spyadrian/fpga-biometric-lock/docs/specification-fr.pdf

## Verrou biométrique

### Cahier des charges du projet FPGA présenté par

## Valentin Bernillon & Adrian Spycher

### Informatique et systèmes de communication avec orientation en systèmes embarqué

### April, 2025

Professeur-e HES responsable Laurent Gantel, Gabriel Da Silva Marques

Valentin Bernillon & Adrian Spycher – Verrou biométrique – April, 2025

## Table des matières

II

## Chapitre 1. Verrou biométrique sur FPGA avec Microblaze et

## Interfaces AXI4-Lite

### 1.1 Objectif

Concevoir et implémenter un système de déverrouillage biométrique utilisant un FPGA sur

la carte Nexys Video. Ce système utilise un processeur soft-core Microblaze pour la gestion

générale et des interfaces AXI4-Lite pour la communication avec les périphériques. Ce projet

utilise une caméra ainsi que l’algorithme LBPH pour la reconnaissance faciale.

### 1.2 Composants du Système

a ) Capteur de Proximité

Un capteur de proximité est utilisé pour détecter l’approche d’un utilisateur. Ce capteur génère

une interruption sur le FPGA lorsqu’une proximité est détectée.

b ) Caméra et Reconnaissance Faciale

Une caméra est intégrée au système pour capturer des images faciales. L’algorithme de recon-

naissance faciale LBPH est implémenté en VHDL pour analyser les images et identifier les

visages autorisés.

c ) Interfaces de Sortie

Un verrou utilisant un électro-aimant est activé pour déverrouiller physiquement une serrure.

d ) Interface Personnalisée

Une interface personnalisée en VHDL est conçue pour faciliter la communication entre le FPGA

et les périphériques spécifiques au projet, tels que le capteur de proximité et la caméra.

e ) Interface Fonctionnant par Interruption

Une interface est configurée pour fonctionner par interruption, permettant au système de réagir

en temps réel aux événements détectés par le capteur de proximité.

### 1.3 Fonctionnement

Lorsqu’un utilisateur s’approche du capteur de proximité, celui-ci déclenche une interruption

sur le FPGA. La caméra capture alors une image faciale, que l’algorithme LBPH analyse pour

reconnaître l’utilisateur. Si l’utilisateur est autorisé, la LED de déverrouillage s’allume en vert

et/ou le moteur de déverrouillage est activé, permettant ainsi l’accès au système sécurisé.

### 1.4 Schéma global

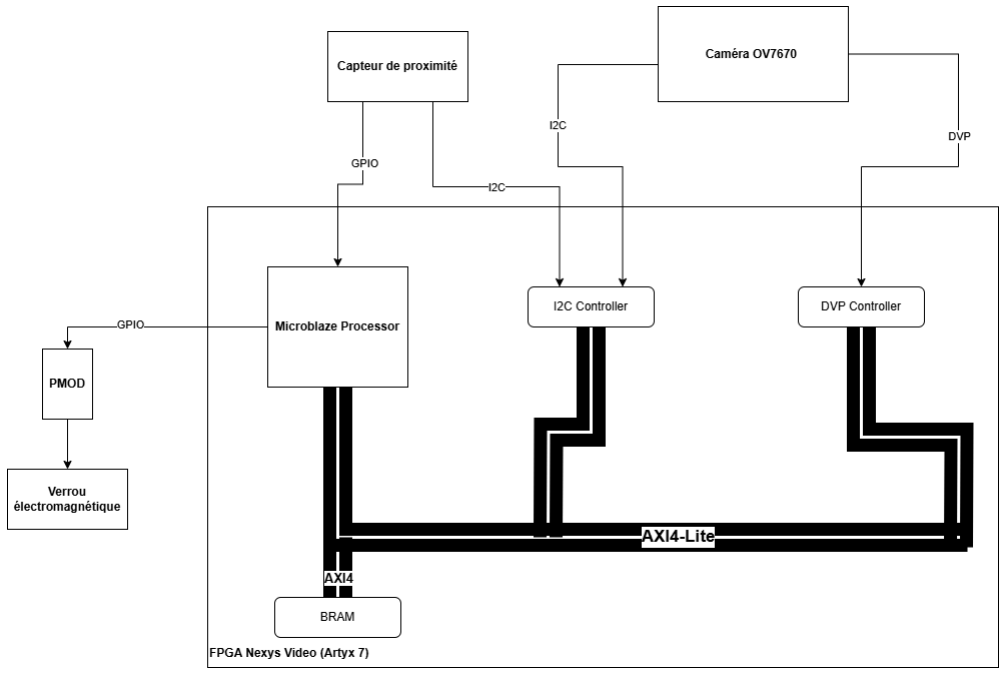
[picture p2: figure]

Fig. 1. – Schéma global du projet de verrou biométrique

### 1.5 Matériel Utilisé :

a ) FPGA - Nexys Video

La Nexys Video, basée sur un FPGA Xilinx Artix-7, est un choix pertinent pour ce projet,

notamment parce que nous l’avons déjà utilisée en cours, ce qui facilite son intégration et son

exploitation.

b ) Caméra - OV7670

La caméra OV7670 est un capteur d’image CMOS à faible coût. Elle fonctionne avec une réso-

lution VGA (640x480) et un débit d’image de 30 FPS, elle est idéale pour les projets embarqués

nécessitant une acquisition rapide d’images en temps réel. Elle communique via une interface

parallèle 8 bits et utilise I2C pour la configuration, ce qui la rend facilement interfaçable avec

un FPGA comme la Nexys Video via un module AXI4-Stream.

- Datasheet (https://www.voti.nl/docs/OV7670.pdf)
- Tutoriel FPGA (https://www.fpga4student.com/2018/08/basys-3-fpga-ov7670-camera.html)

c ) Capteur de proximité

Le VCNL4040 est un capteur de proximité à interface I²C, parfaitement adapté pour détecter la

présence d’un utilisateur et générer une interruption vers le MicroBlaze. Intégré à notre projet,

il permettra de réveiller le système de reconnaissance faciale dès qu’une personne s’approche.

- Datasheet (https://www.vishay.com/docs/84274/vcnl4040.pdf)
- Mouser (https://www.mouser.ch/ProductDetail/Adafruit/4161?qs=d0WKAl%252BL4KYSXIse1Xv7Uw%3D%3D)
- Adafruit guide (https://www.adafruit.com/product/4161)

d ) Verrou à solénoïde - ROB-15324

Un solénoïde électromagnétique est un actionneur qui fonctionne en utilisant un champ magné-

tique pour attirer ou repousser un piston métallique. Alimenté en 5V ou 12V, il est contrôlé par

le FPGA Nexys Video via MicroBlaze.

- Référence (https://www.sparkfun.com/solenoid-12v-latch-lock.html)
- Mouser No : 474-ROB-15324
- Pmod HB3 (https://digilent.com/reference/pmod/pmodhb3/start)

e ) Langages et Outils

VHDL pour la programmation des interfaces et des algorithmes, Xilinx Vivado pour la concep-

tion et la synthèse du FPGA.
