spyadrian/fpga-biometric-lock/docs/presentation-fr.pdf

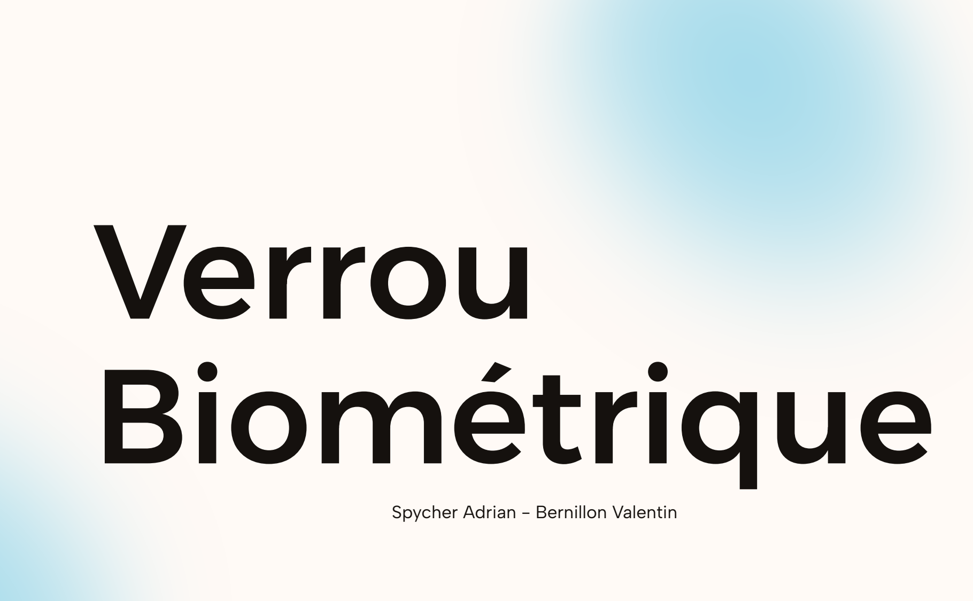
[picture p3: page 1]

# Verrou Biométrique

Spycher Adrian - Bernillon Valentin

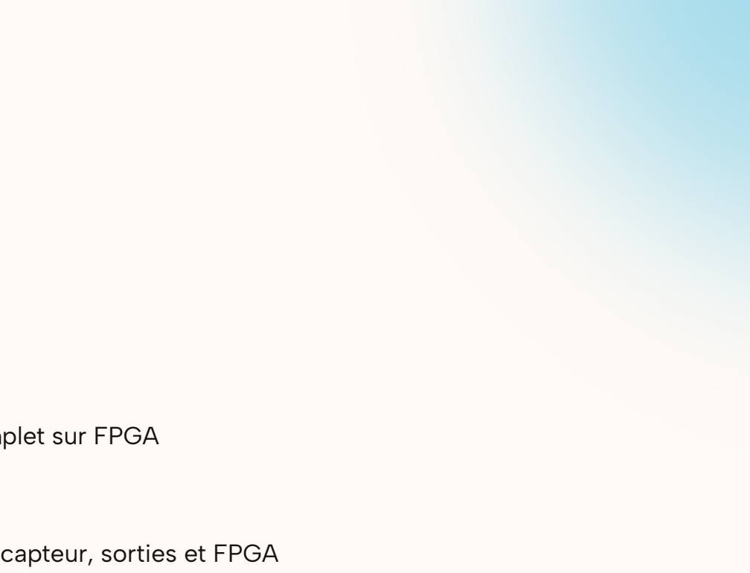
[picture p4: figure]

- Conception et implémentation d’un projet complet sur FPGA
- Mise en place d’un cahier des charges
- Proposition d’une solution complète, integrant capteur, sorties et FPGA

# Contexte

# Objectif

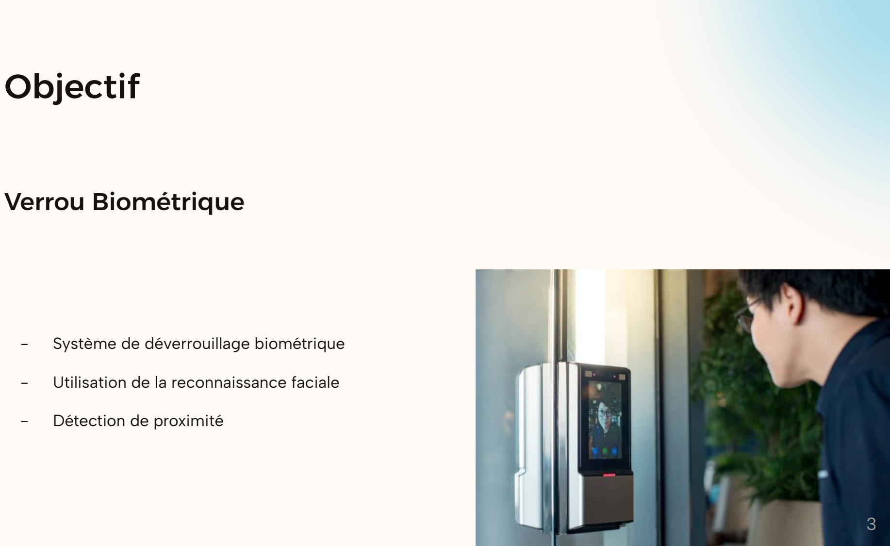
[picture p5: page 3]

- Système de déverrouillage biométrique
- Utilisation de la reconnaissance faciale
- Détection de proximité

## Verrou Biométrique

- Déverrouillage biométrique
- FPGA sur Nexys Video

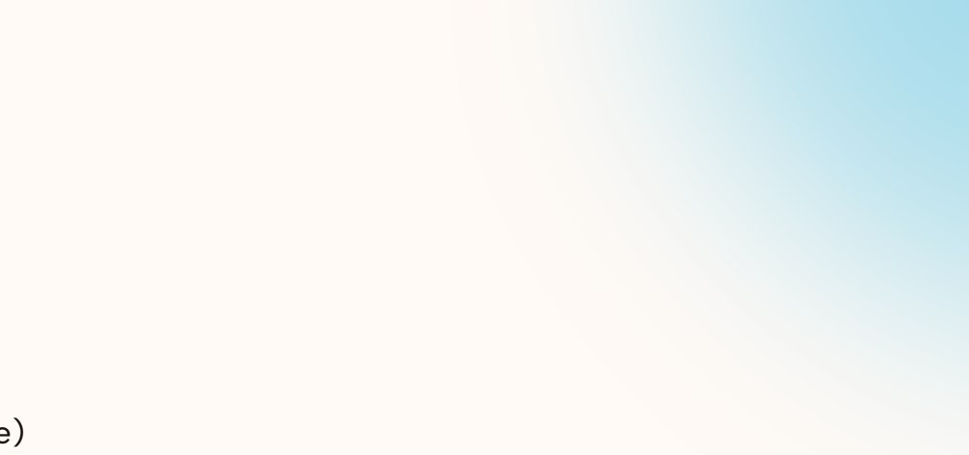
[picture p6: figure]

- Utilisation du processeur Microblaze (AXI4-Lite)
- Caméra et algorithme LBPH

# Cahier des charges

- Capteurs de proximité
- Caméra
- Verrou magnétique
- Sortie vidéo

## Objectifs

## Composants

01 | Architecture globale
02 | Architecture détaillée
03 | Conclusion

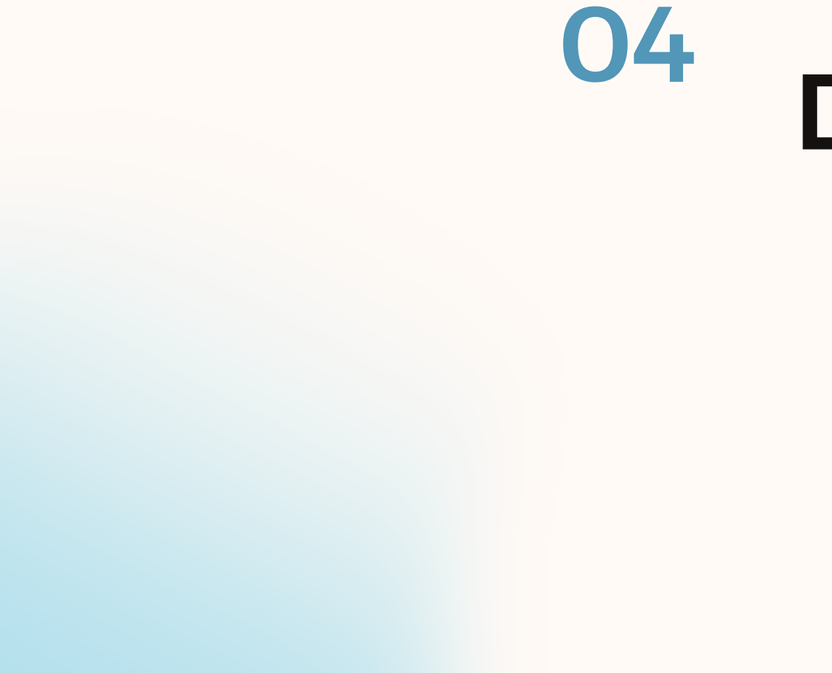
[picture p7: figure]

04 | Démonstration

# Sommaire

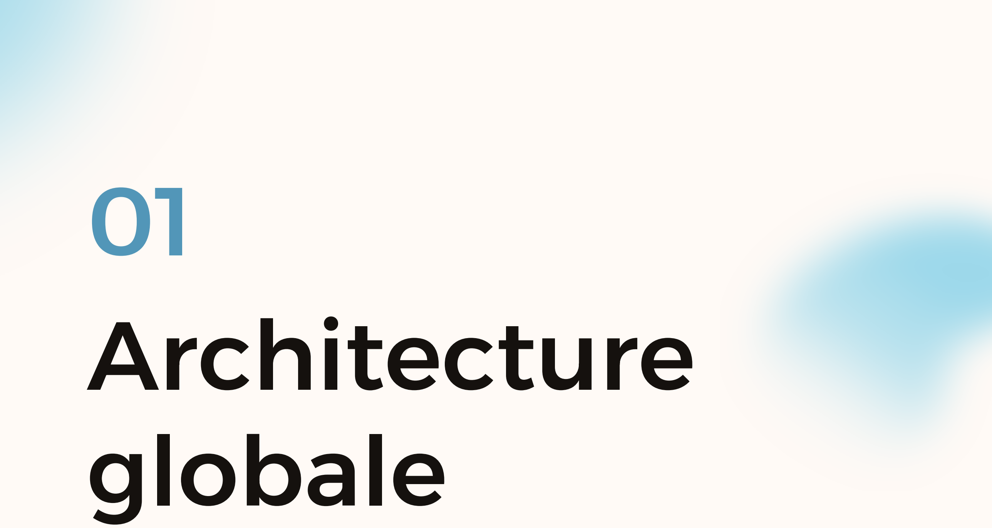
[picture p8: page 6]

# globale

01

# Architecture

# Schéma Bloc - Architecture initiale

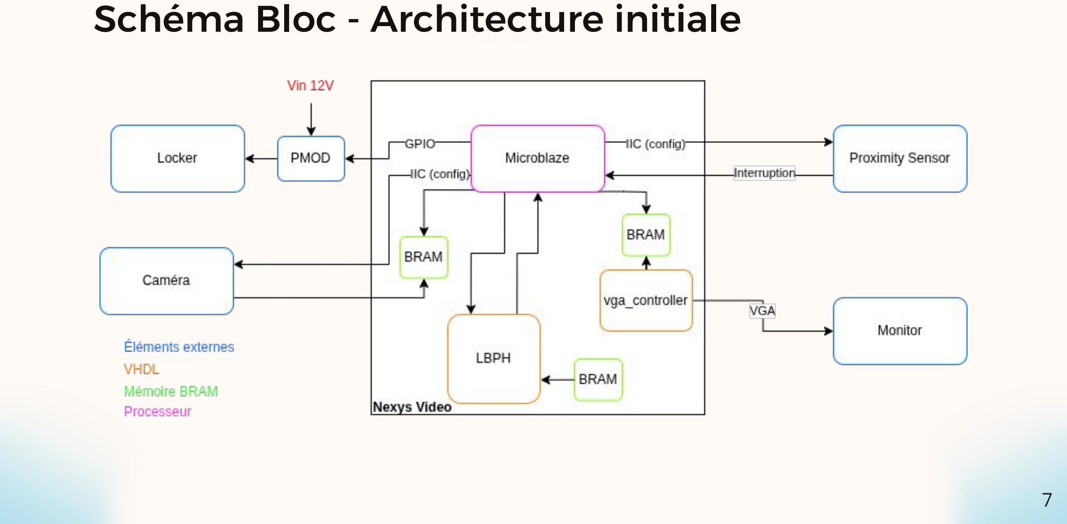
[picture p9: page 7]

# Schéma Bloc - Architecture adaptée

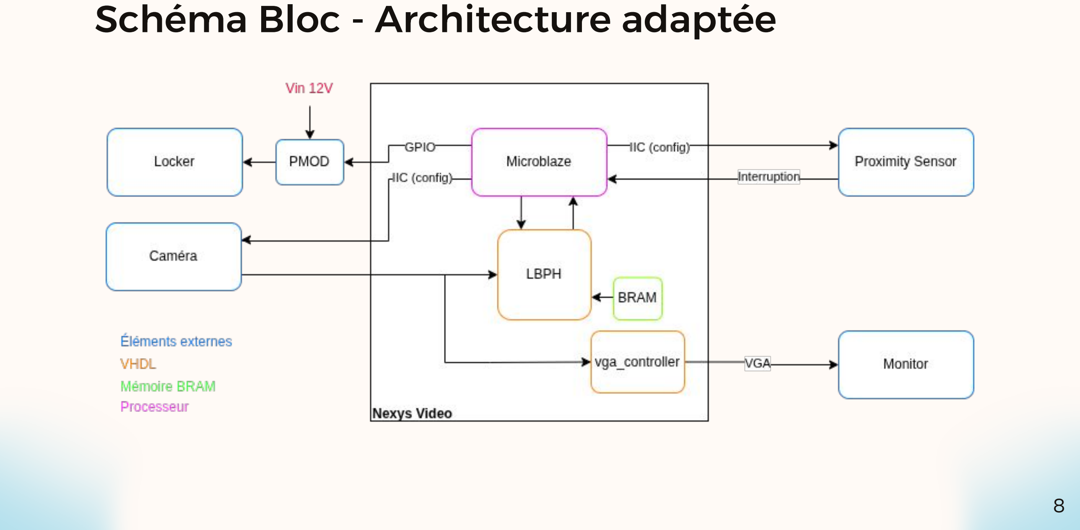
[picture p10: page 8]
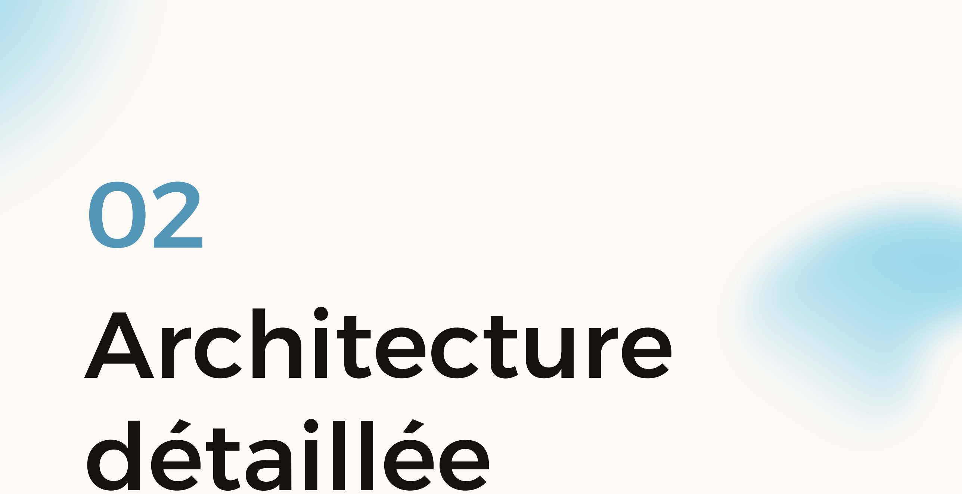
[picture p11: page 9]

# détaillée

02

# Architecture

# Verrou - Solenoid Pull 12V

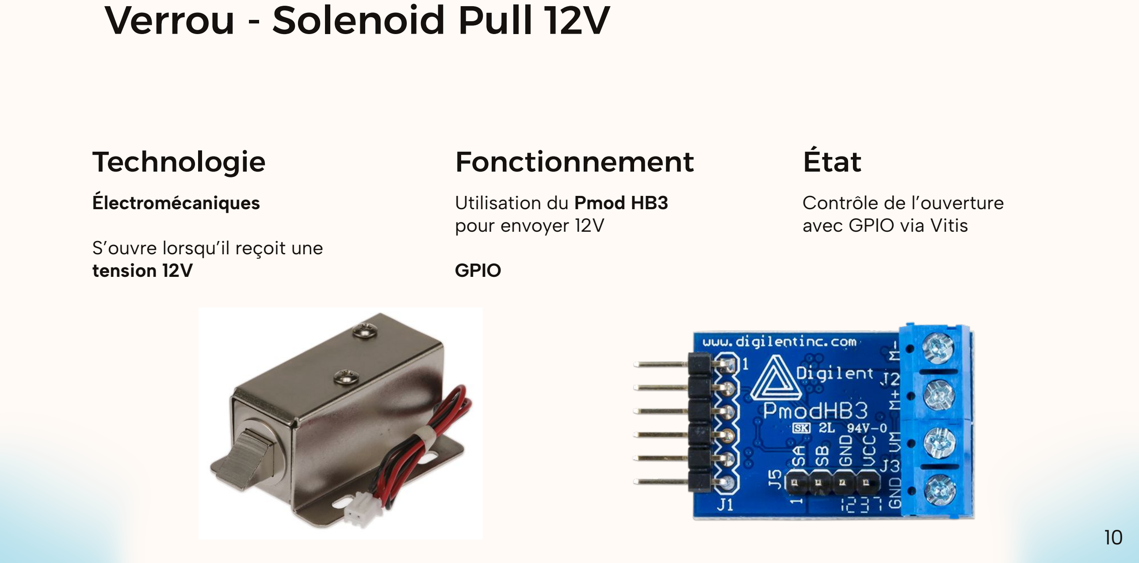
[picture p12: page 10]

Électromécaniques

S’ouvre lorsqu’il reçoit une tension 12V

## Technologie

Utilisation du Pmod HB3
pour envoyer 12V

GPIO

## Fonctionnement

Contrôle de l’ouverture
avec GPIO via Vitis

## État

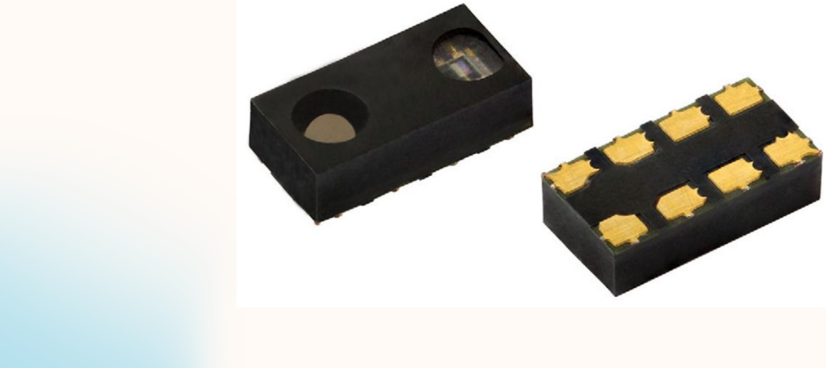
[picture p13: figure]

Capteur de présence
infrarouge et de lumière
ambiante

# Capteur de Proximité - VCNL4040

## Technologie

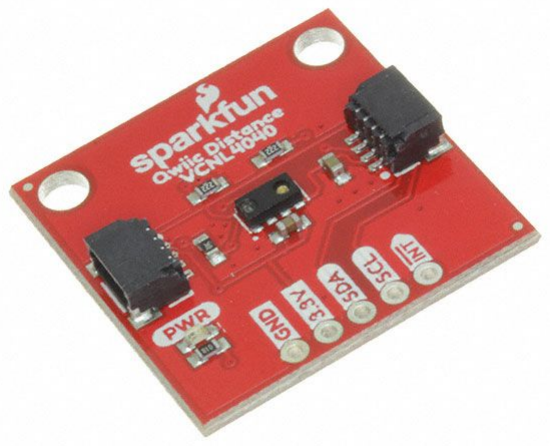
[picture p14: figure]

Configuration via I2C

Émets une interruption lors de l’apparition ou
disparition d’un objet

## Fonctionnement

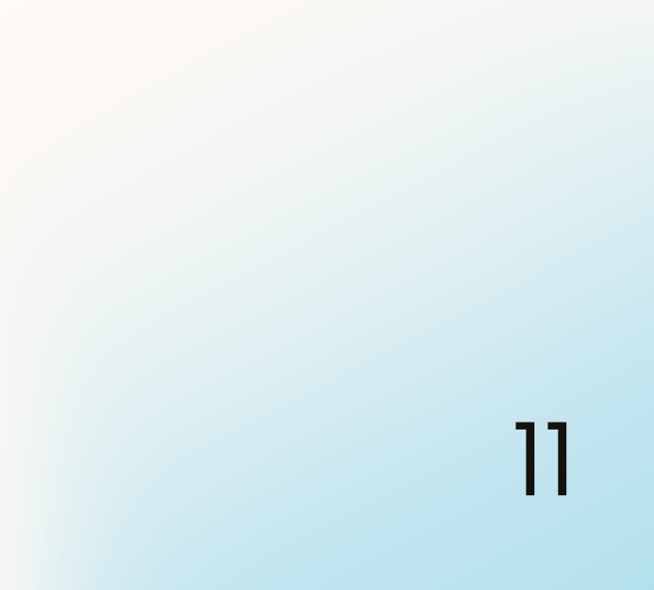
[picture p15: figure]

Configuration émise lors de l’initialisation de la carte

Interruption GPIO activée
lors de l’approche d’un
objet

## État

# Écran - VGA

Retransmission des

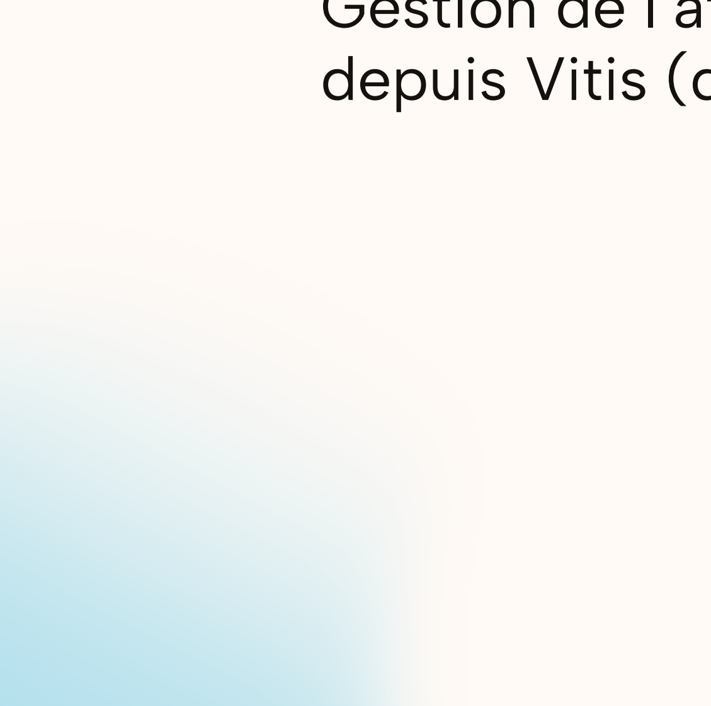
[picture p16: figure]

données capturés par la
caméra

Configurable directement
depuis Vitis

Gestion de l’affichage
depuis Vitis (draw_pixel, …)

## Objectifs

Création d’une IP
contrôleur VGA par AXI

Utilisation d’une BRAM
pour le framebuffer

Implémentation d’un
contrôleur AXI BRAM

Limitation de l’affichage
(test)

## Réalisation

Décalage présent

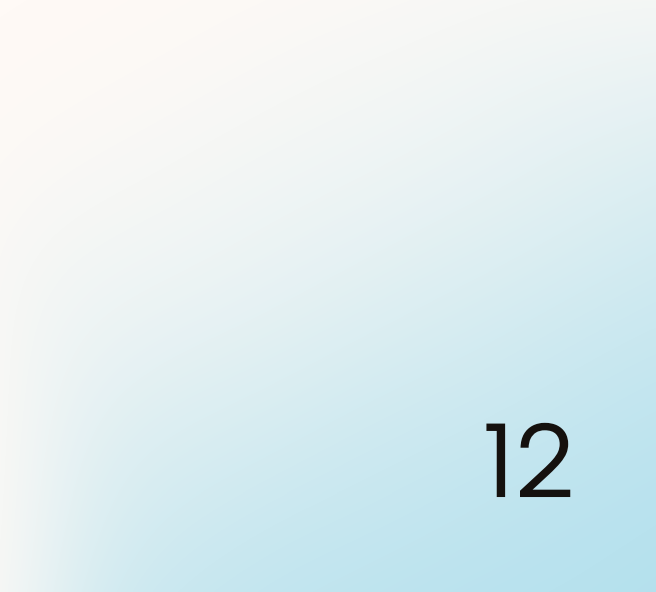
[picture p17: figure]

Retour vers une solution
plus simple, mais plus
adaptée au projet

## Etat actuel

# Écran - VGA

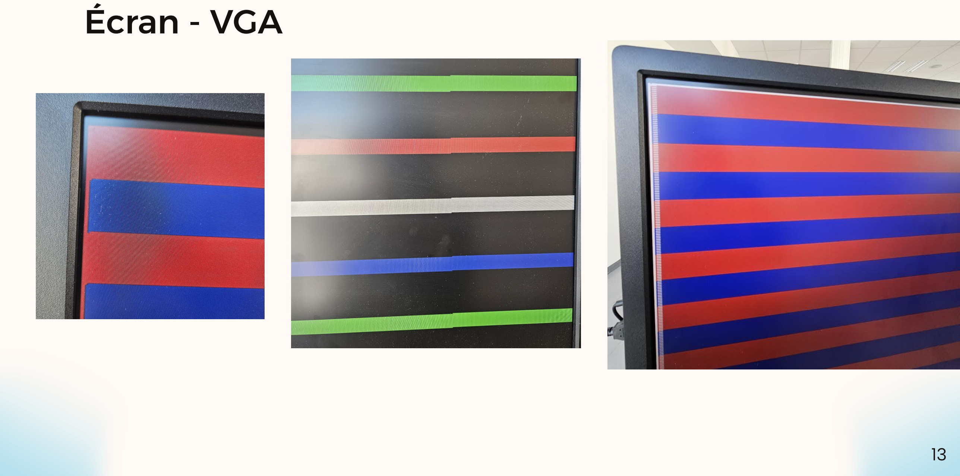
[picture p18: page 13]

Par I2C, utilisation de l’IP

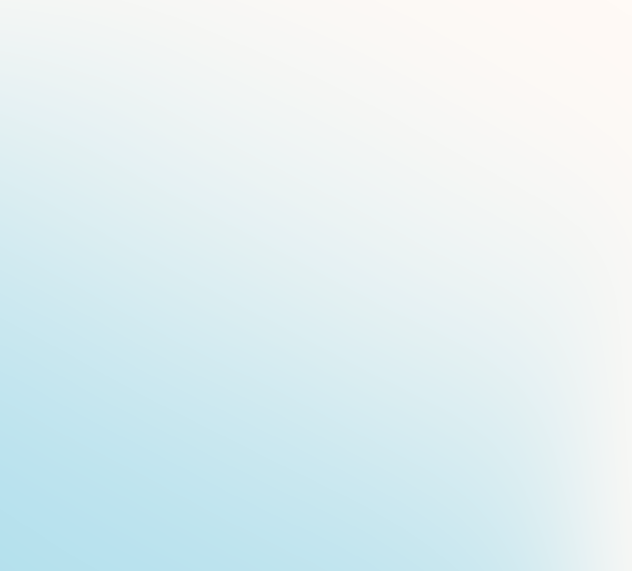
[picture p19: figure]

AXI IIC dans Vivado

Format RGB565

Résolution 640x480

# Caméra - OV7670

## Configuration

Transmission ligne par ligne (VS, HS, PCLK)

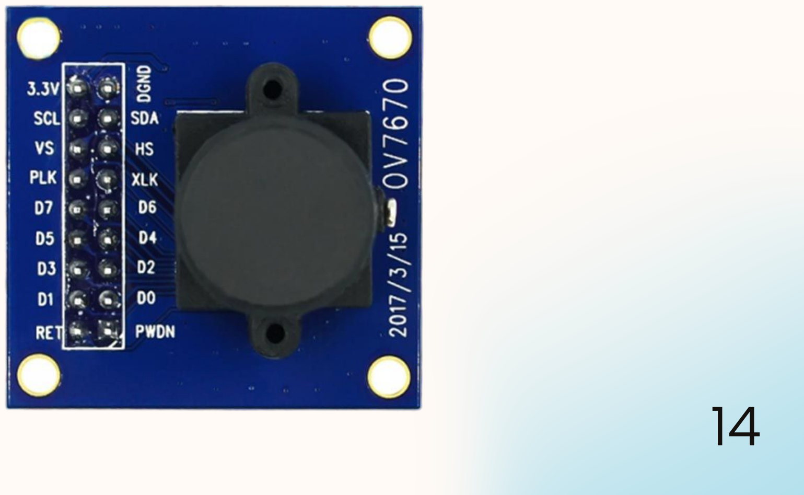
[picture p20: figure]

Données envoyées sur les
lignes D[7:0] au rythme du PCLK lorsque HREF est
actif

Adaptation des modules
VHDL

## Données

Configuration par IIC mise en place

Retour vidéo non testé

Intégration dans
l’architecture valide

## Implémentation actuelle

# Reconnaissance Faciale - LBPH (Local Binary Patterns Histograms)

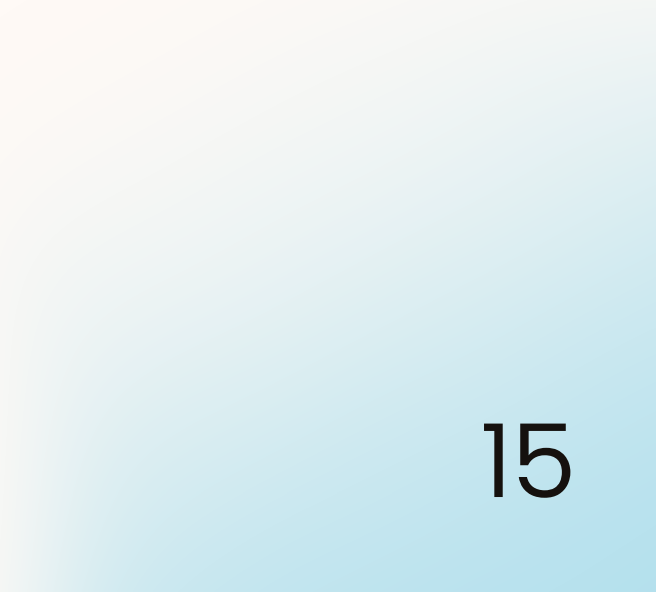
[picture p21: figure]

- Convolution
- Création de l’histogramme
- Évaluation de la distance

## 3 Étapes

# LBPH 1er Étape - Convolution

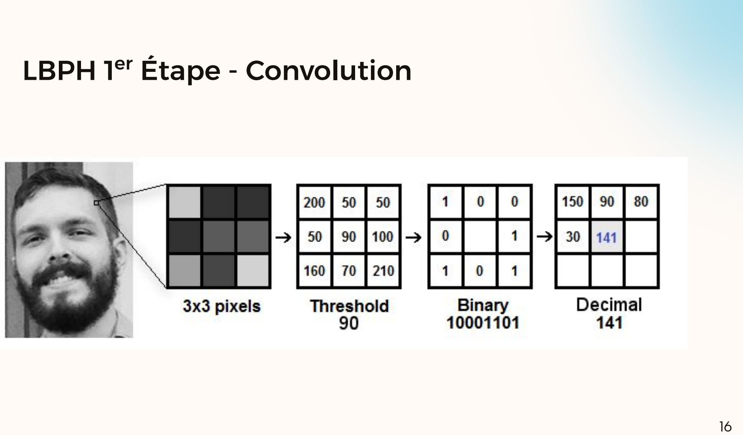
[picture p22: page 16]

# LBPH 2e Étape - Création de l'Histogramme

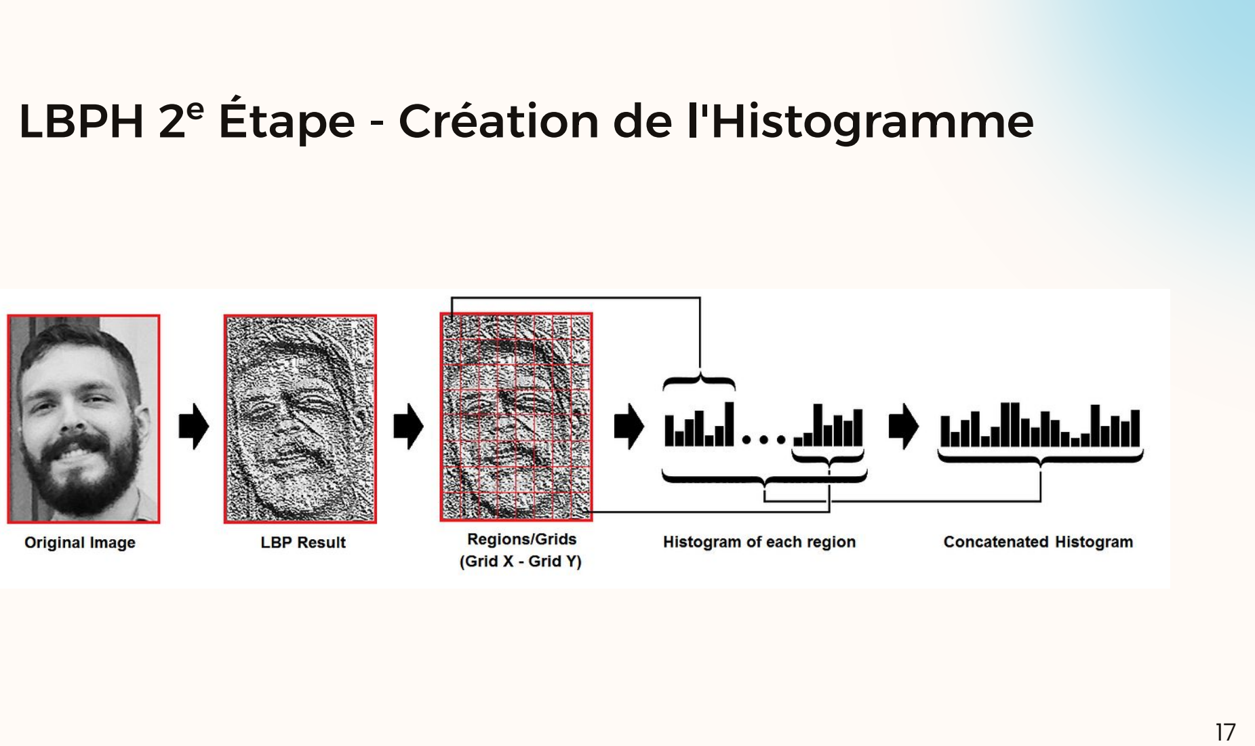
[picture p23: page 17]

# LBPH 3e Étape - Évaluation de la Distance

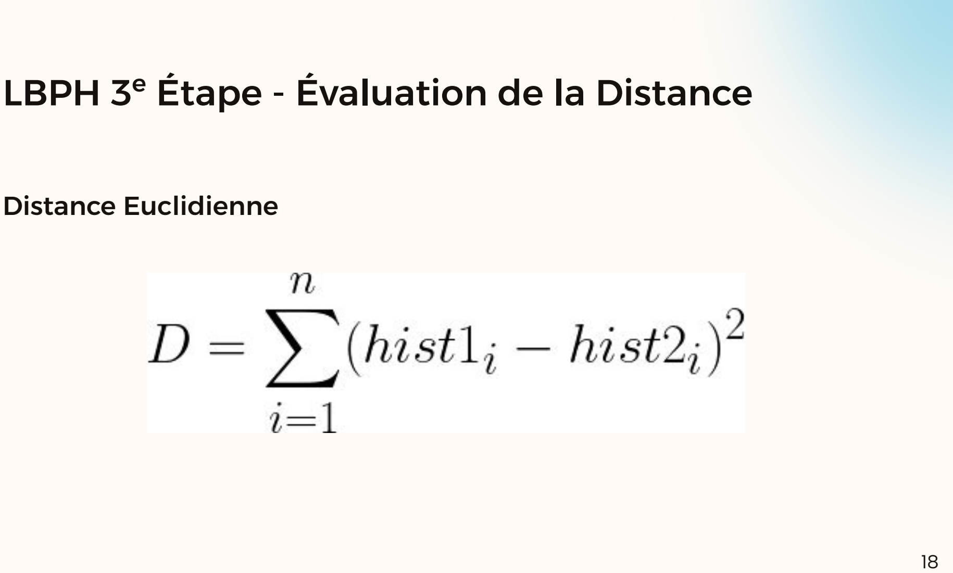
[picture p24: page 18]

## Distance Euclidienne

# LBPH en VHDL

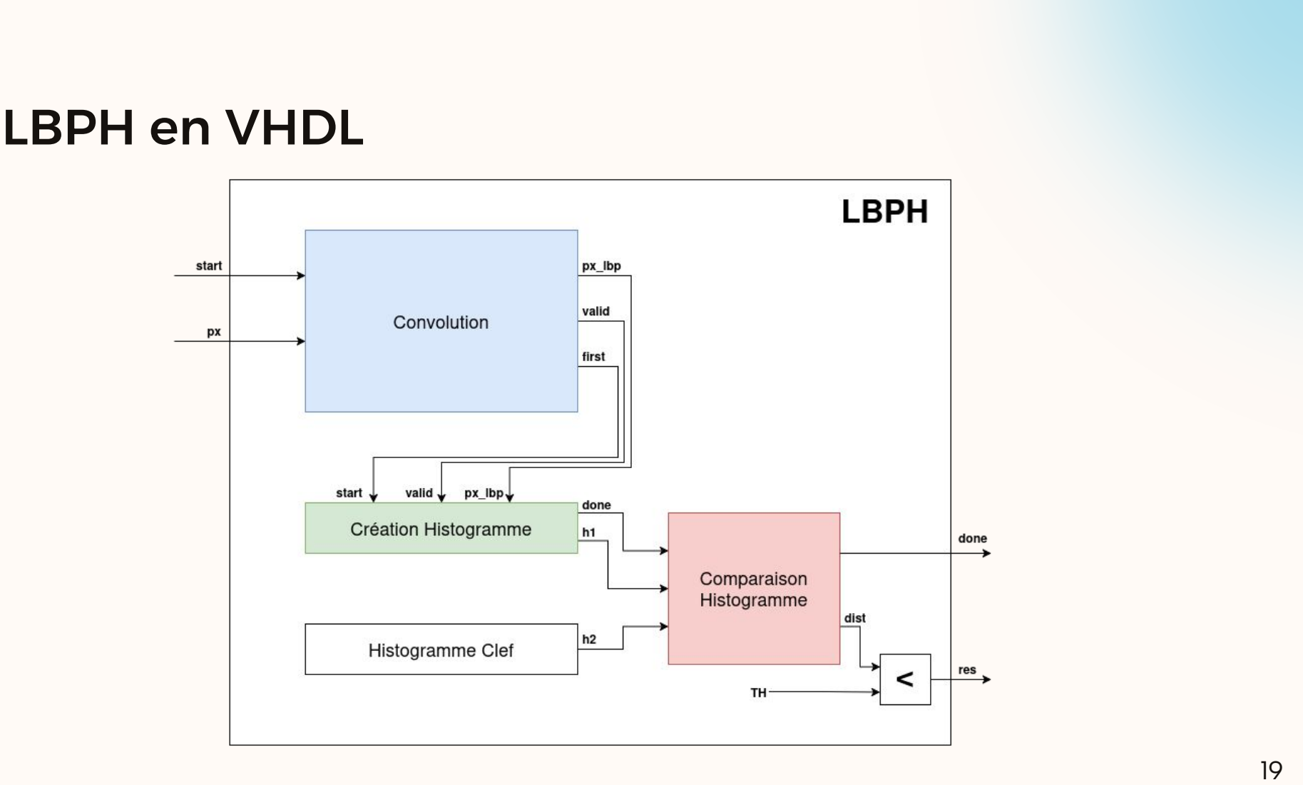
[picture p25: page 19]

# LBPH en VHDL

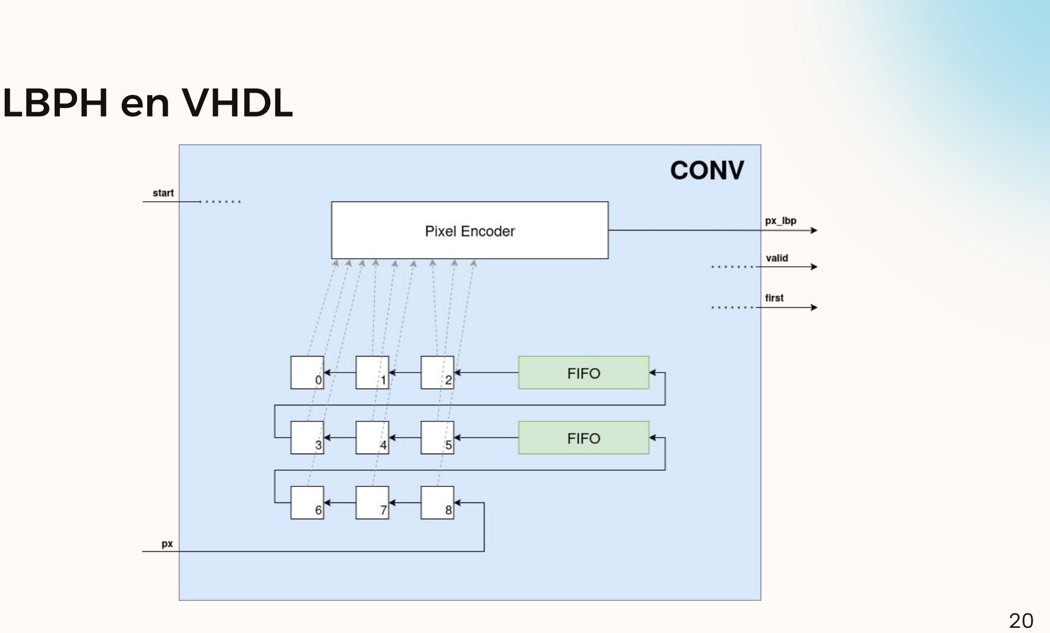
[picture p26: page 20]
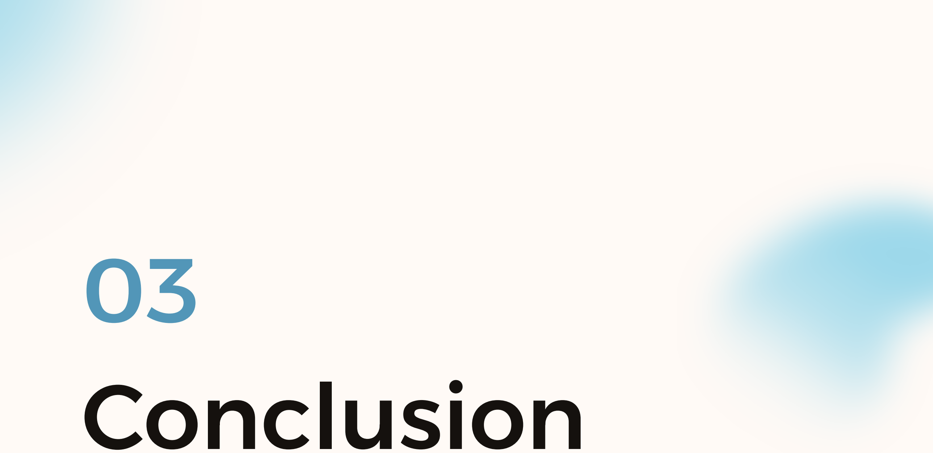
[picture p27: page 21]

03

# Conclusion

- Prise en main de la création d’IP personnalisée
- Mise en place d’une architecture complète

# Conclusion

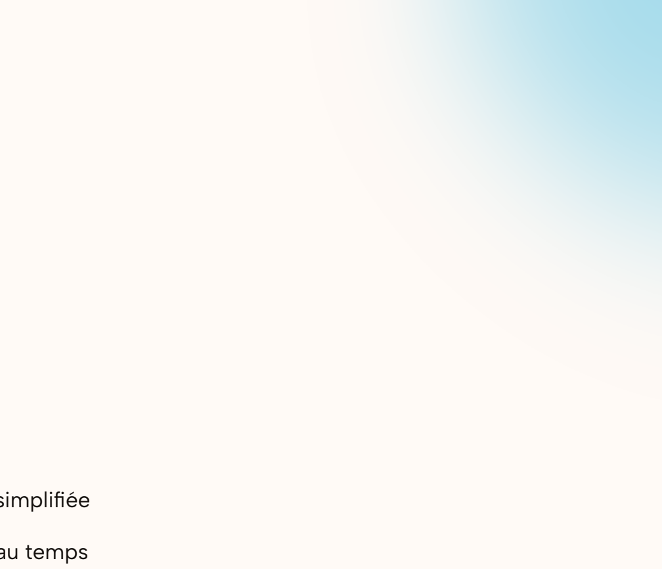
[picture p28: figure]

- Finalisation de l’architecture dans une version simplifiée
- Tests de fonctionnement de la caméra
- Mise en place d’un cahier des charges adapté au temps

## Bilan du Projet

## Amélioration Possible

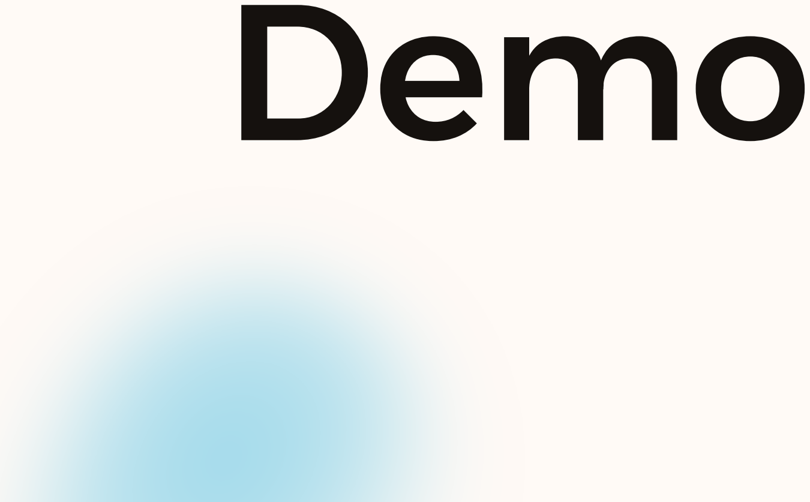
[picture p29: page 23]

# Demo

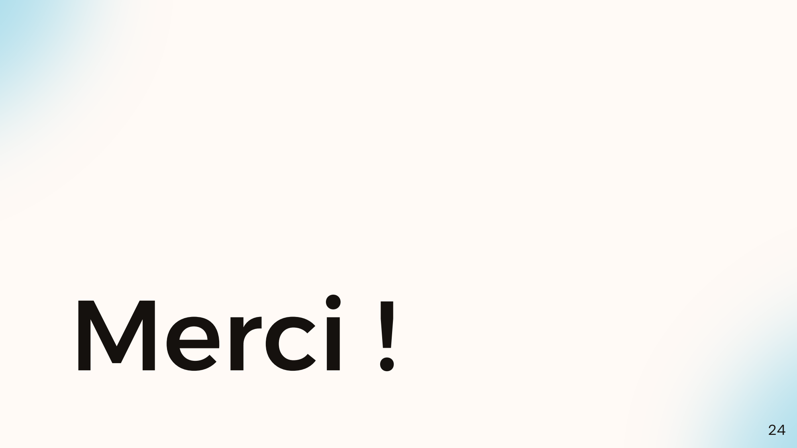
[picture p30: page 24]

# Merci !
