spyadrian/fpga-biometric-lock/circuits/src/hdl/lbph_pkg.vhd

library lbph;

library ieee;
use ieee.numeric_std.all;
use ieee.std_logic_1164.all;
use ieee.std_logic_textio.all;

package lbph_pkg is

    ---------------------------------------------------------------------------------
    -- Constants
    ---------------------------------------------------------------------------------

    constant IMG_HEIGHT      : integer := 640;
    constant IMG_WIDTH       : integer := 480;
    constant NUM_PIXELS      : integer := IMG_WIDTH * IMG_HEIGHT;

    constant GRID_LEN_X      : integer := 8;
    constant GRID_LEN_Y      : integer := 8; 

    constant GRID_WIDTH      : integer := 60;               -- round(LBP_IMG_WIDTH / GRID_LEN_X);
    constant GRID_HEIGHT     : integer := 80;               -- round(LBP_IMG_HEIGHT / GRID_LEN_Y);

    constant PXL_SIZE        : integer := 8;
    constant LBP_BINS        : integer := 256;              -- number of colors

    constant MATCH_THRESHOLD : integer := 50;               -- random value for the moment


    ---------------------------------------------------------------------------------
    -- Types
    ---------------------------------------------------------------------------------

    subtype pixel_t is std_logic_vector(PXL_SIZE - 1 downto 0);
    type image_t is array (0 to IMG_HEIGHT - 1, 0 to IMG_WIDTH - 1) of pixel_t;

    subtype lbp_value_t is unsigned(PXL_SIZE - 1 downto 0);
    -- type lbp_image_t is array (0 to IMG_HEIGHT - 1 - 2, 0 to IMG_WIDTH - 1 - 2) of lbp_value_t;

    subtype bin_t is unsigned(12 downto 0);                                             -- 13-bit (8'192 > 4800 -> max value of a bin)
    type hist_t is array (0 to LBP_BINS - 1) of bin_t;
    type concat_hist_t is array (0 to GRID_LEN_Y - 1, 0 to GRID_LEN_X - 1) of hist_t;
    
    subtype distance_t is unsigned(39 downto 0);                                        -- 40-bit (max of the sum)


    ---------------------------------------------------------------------------------
    -- Components
    ---------------------------------------------------------------------------------

    -- ...


    ---------------------------------------------------------------------------------
    -- Functions
    ---------------------------------------------------------------------------------

    function squared_diff(bin1, bin2 : bin_t) return distance_t;
    
    function get_grid_x(x : integer) return integer;
    function get_grid_y(y : integer) return integer;


    ---------------------------------------------------------------------------------
    -- Procedures
    ---------------------------------------------------------------------------------

    -- ...


end lbph_pkg;


package body lbph_pkg is

    ---------------------------------------------------------------------------------
    -- FUNCTIONS
    ---------------------------------------------------------------------------------

    function squared_diff(bin1, bin2 : bin_t) return distance_t is
    
        variable diff     : signed(16 downto 0);
        variable square   : signed(39 downto 0);
        variable distance : distance_t := (others => '0');
    begin
    
        diff := signed(resize(bin1, 17)) - signed(resize(bin2, 17));
        square := resize(diff * diff, 40);
        distance := unsigned(square);
        
        return distance;
    end function;


    function get_grid_x(x : integer) return integer is
    begin
    
        if x < GRID_WIDTH * 1 then
            return 0;
        elsif x < GRID_WIDTH * 2 then
            return 1;
        elsif x < GRID_WIDTH * 3 then
            return 2;
        elsif x < GRID_WIDTH * 4 then
            return 3;
        elsif x < GRID_WIDTH * 5 then
            return 4;
        elsif x < GRID_WIDTH * 6 then
            return 5;
        elsif x < GRID_WIDTH * 7 then
            return 6;
        else
            return 7;
        end if;
    
    end function;
    
    
    function get_grid_y(y : integer) return integer is
    begin
    
        if y < GRID_HEIGHT * 1 then
            return 0;
        elsif y < GRID_HEIGHT * 2 then
            return 1;
        elsif y < GRID_HEIGHT * 3 then
            return 2;
        elsif y < GRID_HEIGHT * 4 then
            return 3;
        elsif y < GRID_HEIGHT * 5 then
            return 4;
        elsif y < GRID_HEIGHT * 6 then
            return 5;
        elsif y < GRID_HEIGHT * 7 then
            return 6;
        else
            return 7;
        end if;
        
    end function;


end package body;
