spyadrian/fpga-biometric-lock/(commit log)

2025-03-03 feat: set up circuit folder
2025-03-03 Upload hardware for 1st i2c test
2025-04-15 feat: rename and fix comparaison module
    [lbph_comp.vhd, tb_lbph_comp.vhd]
2025-04-25 fix: conv iterate on last line
    [lbph_conv.vhd]
2025-05-12 feat: add Vitis C program for GPIO's Interrupt Demo
2025-05-12 feat: add readme for circuits
2025-05-12 docs: compile pdf and add them to the git just in case
2026-11-13 docs: rewrite README with the real project status, tidy layout
    - README: concept, what was achieved (lock + sensor on board, LBPH in
    simulation, camera/VGA not integrated), VHDL entities, software, build
    - Move report, specification and slides to docs/ (PDF only, no Typst)
    - Remove third-party datasheets, the French README and circuits/readme.md
    - Rename the Vitis test programs by purpose, drop an identical duplicate
    and editor files; remove the teacher's e-mail from the Tcl headers
    - Add MIT license
